Timo-Hauser/POWERPANEL-HW/images/pcb/2d_bottom.png

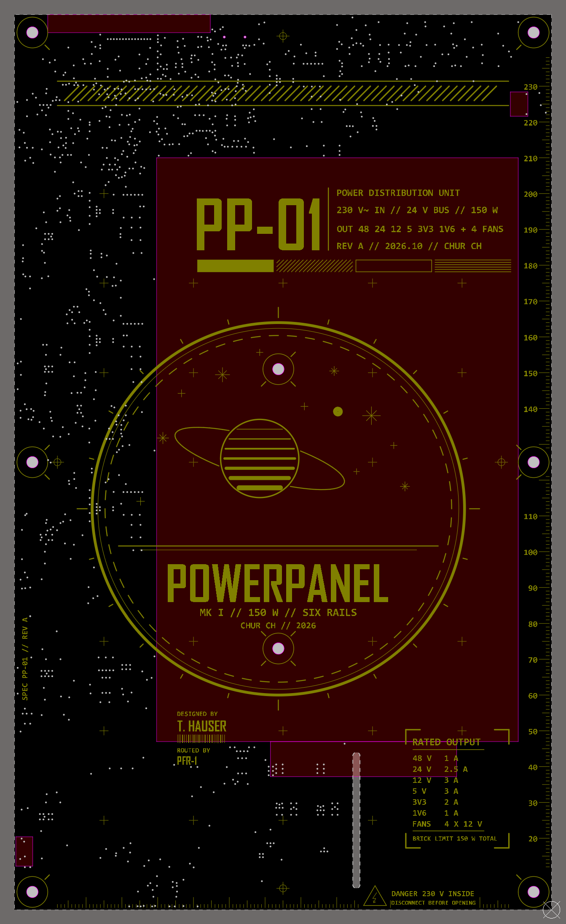
images/pcb/2d_bottom.png
