Timo-Hauser/POWERPANEL-HW/images/pcb/2d_top.png

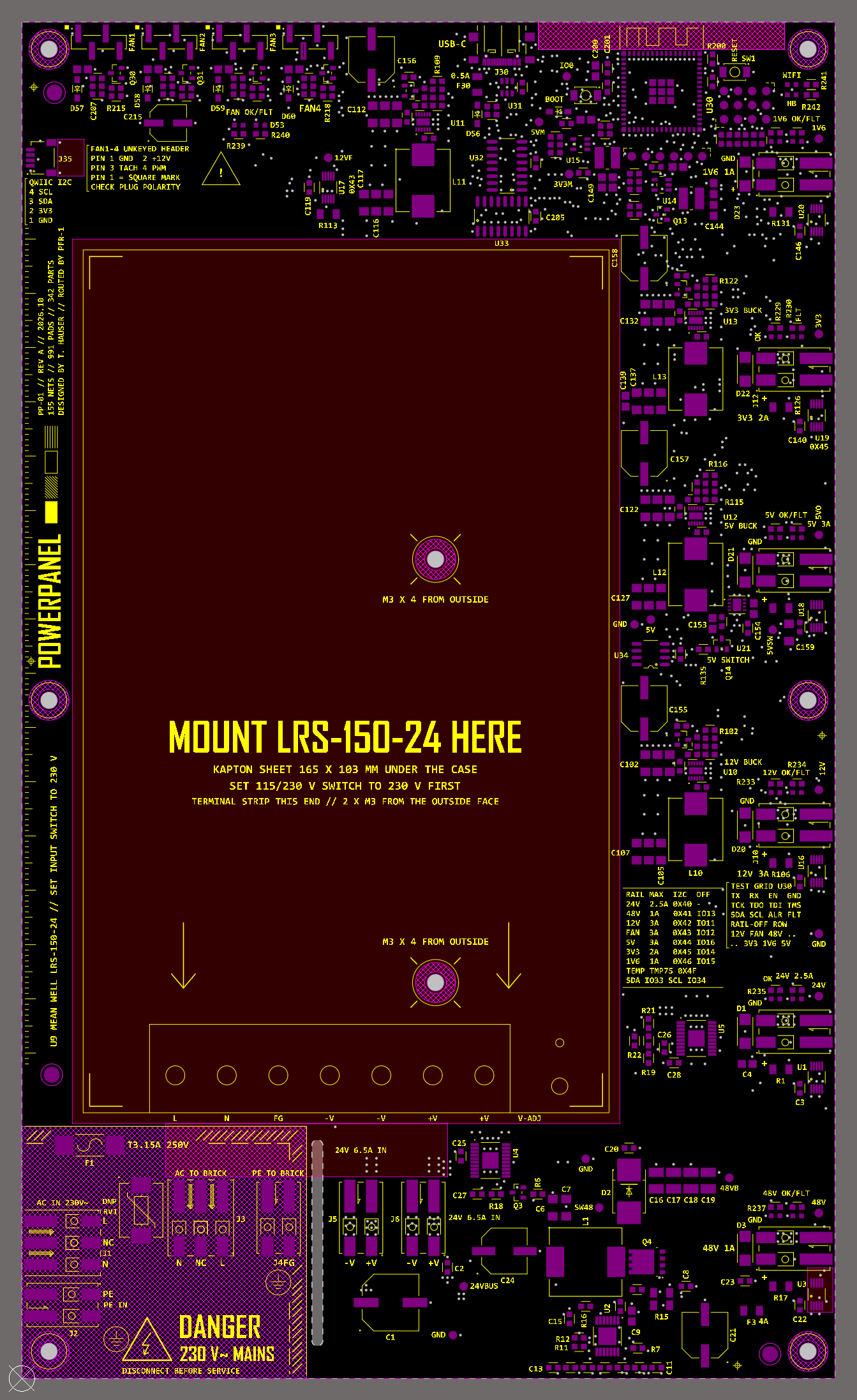
images/pcb/2d_top.png
