Timo-Hauser/POWERPANEL-HW/images/pcb/3d_angled.png

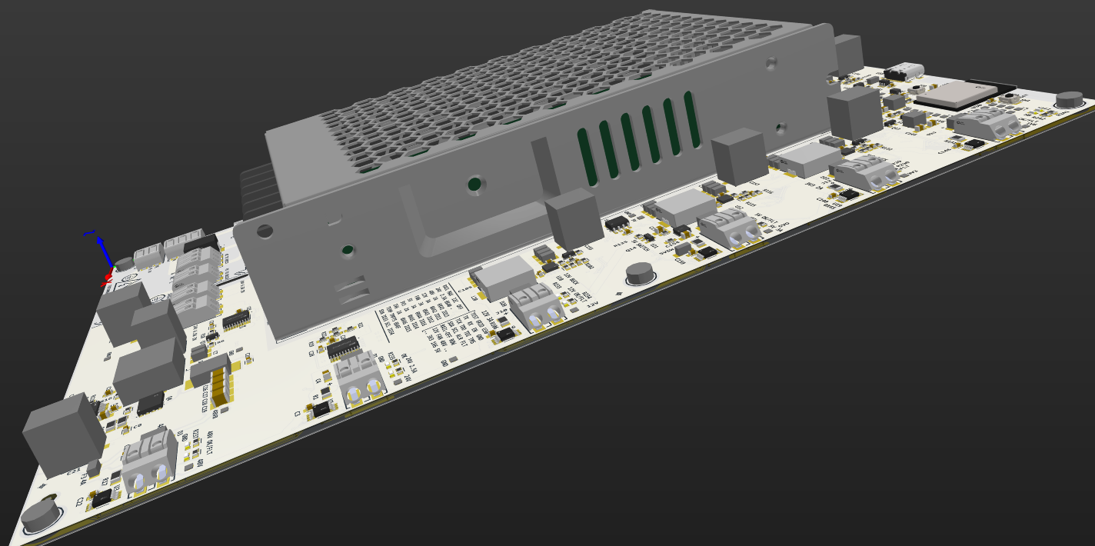
images/pcb/3d_angled.png
