Timo-Hauser/POWERPANEL-HW/images/pcb/3d_emblem.png

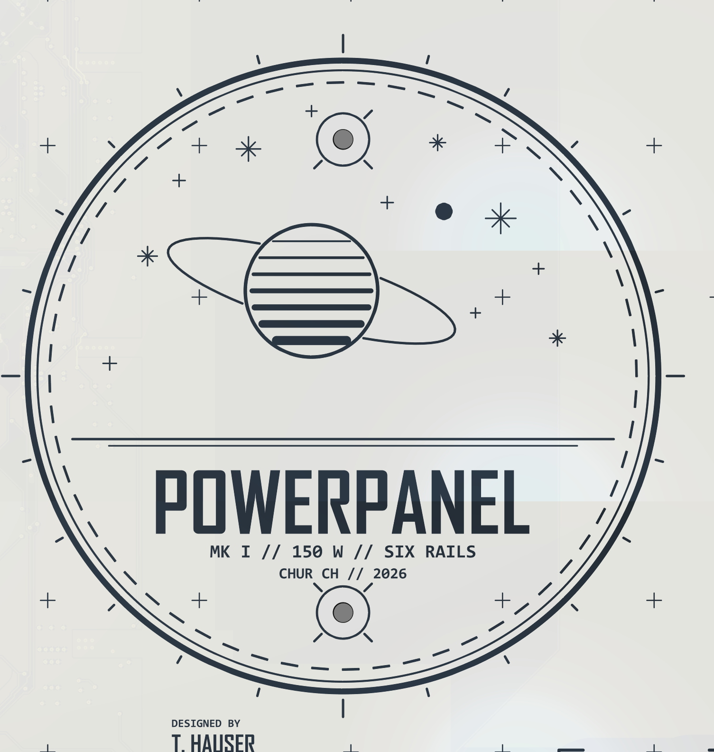
images/pcb/3d_emblem.png
