Timo-Hauser/POWERPANEL-HW/images/pcb/3d_fans.png

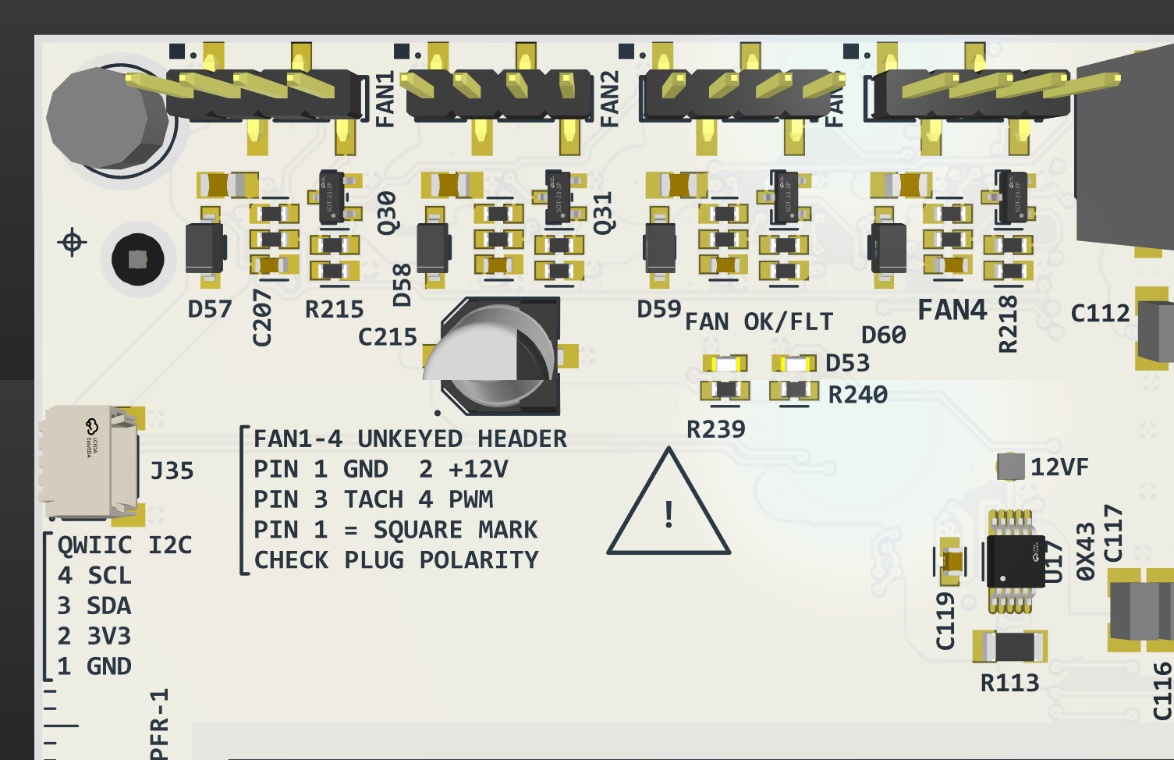
images/pcb/3d_fans.png
