Timo-Hauser/POWERPANEL-HW/images/pcb/3d_mains.png

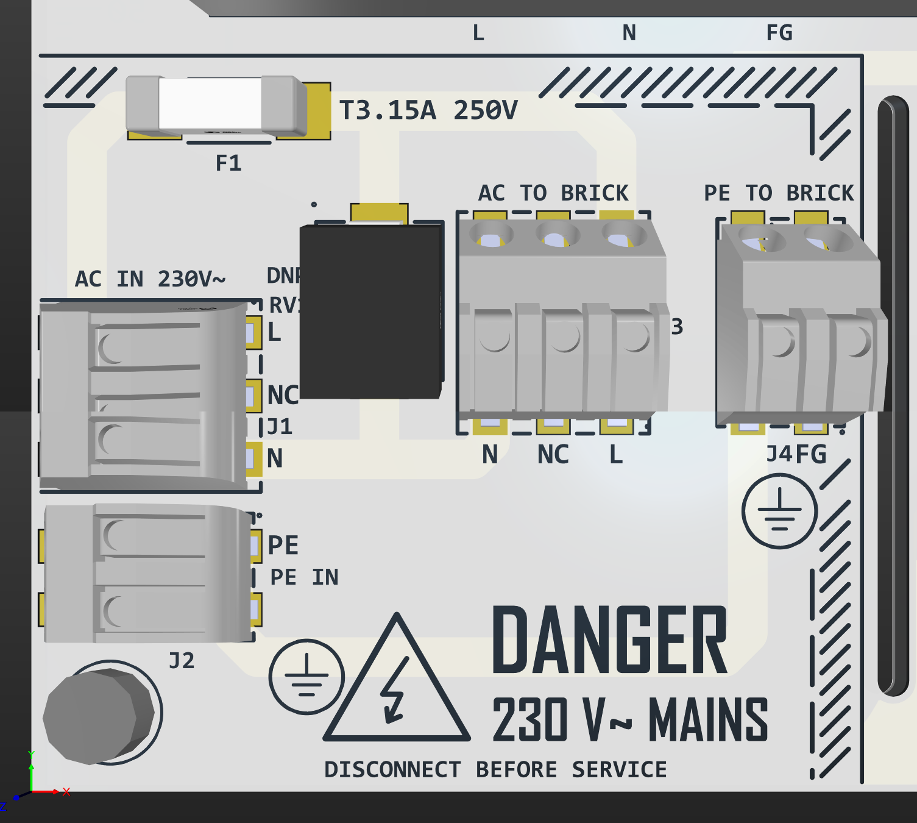
images/pcb/3d_mains.png
