Timo-Hauser/POWERPANEL-HW/images/pcb/3d_psu_top.png

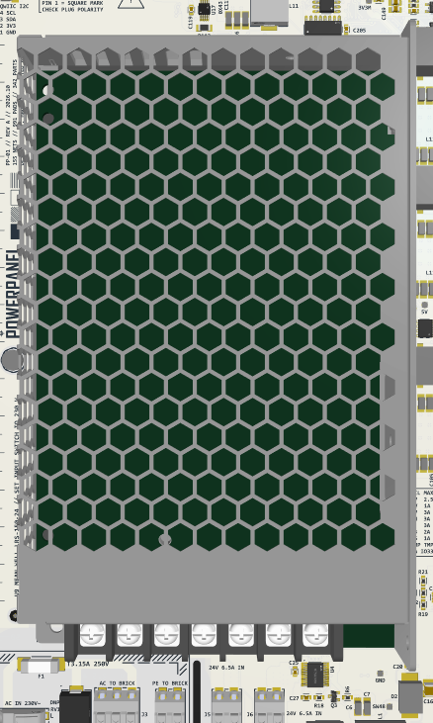
images/pcb/3d_psu_top.png
