Timo-Hauser/POWERPANEL-HW/images/pcb/3d_terminals.png

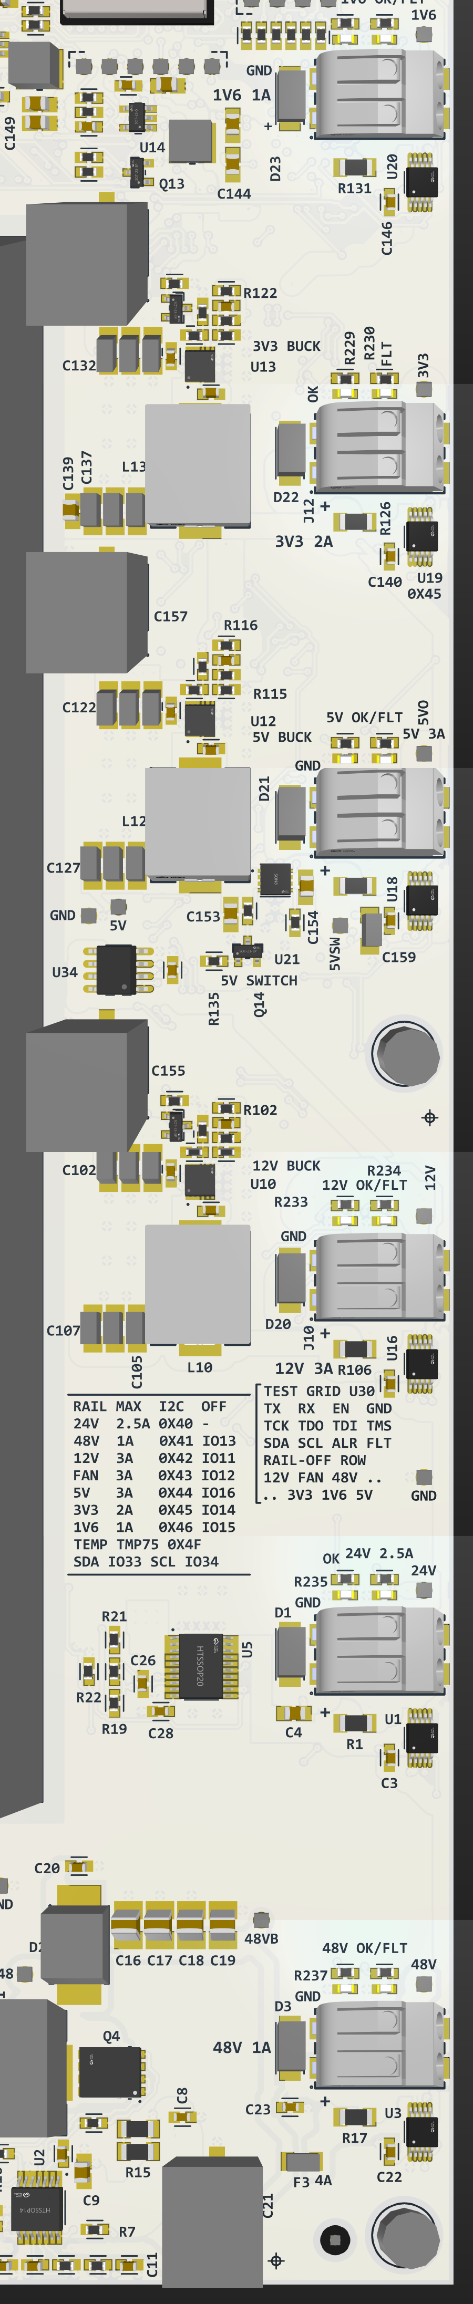
images/pcb/3d_terminals.png
