Timo-Hauser/POWERPANEL-HW/images/pcb/3d_top.png

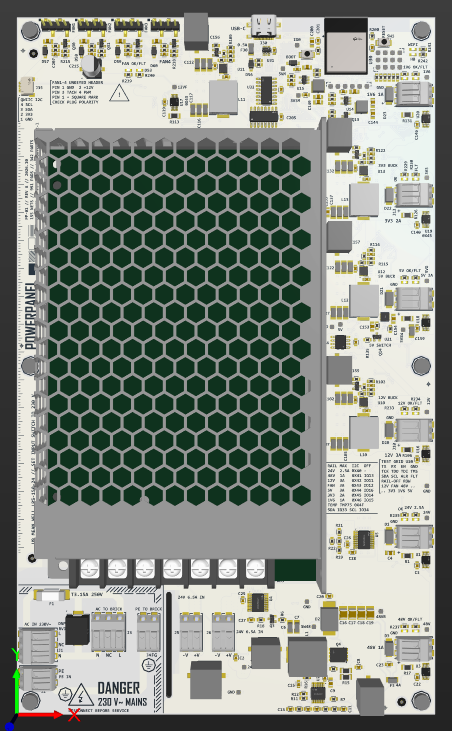
images/pcb/3d_top.png
