Timo-Hauser/POWERPANEL-HW/fab/PowerPanel_BOM_JLC.csv

Comment | Designator | Footprint | LCSC Part #
220U | C1 | CAPAE_D10X10.5 | C46550417
100N | C2,C3,C8,C12,C13,C22,C25,C26,C103,C104,C109,C113,C114,C119,C123,C124,C129,C133,C134,C140,C142,C146,C150,C151,C201,C203,C204,C205,C206 | CAP0603 | C14663
1U | C4,C9 | CAP0805 | C28323
10U | C6,C7,C100,C101,C102,C110,C111,C112,C120,C121,C122,C130,C131,C132 | CAP1206 | C13585
1U | C10,C202 | CAP0603 | C15849
1N | C11,C14 | CAP0603 | C1588
100P | C15 | CAP0603 | C14858
4U7 | C16,C17,C18,C19 | CAP1210 | C381466
100N | C20,C23 | CAP0603 | C15725
47U | C21,C24,C155,C156,C157,C158 | CAPAE_D8X10.5 | C48935391
10N | C27,C28,C207,C208,C209,C210 | CAP0603 | C57112
22U | C105,C106,C107,C115,C116,C117 | CAP1206 | C12891
33P | C108,C118,C128,C138 | CAP0603 | C1663
47U | C125,C126,C127,C135,C136,C137,C159 | CAP1206 | C96123
22U | C139,C143,C144,C148,C149,C200 | CAP0805 | C45783
10U | C141,C147,C153,C154,C211,C212,C213,C214 | CAP0805 | C15850
22P | C145,C152 | CAP0603 | C1653
220U | C215 | CAPAE_D6.3X7.7 | C46550404
24V | D1 | SMA | C19077541
100V 5A | D2 | SMC | C414013
48V | D3 | SMA | C223991
12V | D20 | SMA | C19077532
5V0 | D21,D22,D23 | SMA | C19077523
GREEN | D40,D42,D44,D46,D48,D50,D52 | LED0603 | C965804
RED | D41,D43,D45,D47,D49,D51,D53 | LED0603 | C2286
BLUE | D54 | LED0603 | C965807
WHITE | D55 | LED0603 | C2290
B5819W | D56,D57,D58,D59,D60,D61 | SOD-123 | C8598
3A15 | F1 | FUSE_SCT1032 | C19712564
4A | F3 | FUSE1206 | C136349
500MA | F30 | FUSE1206 | C883126
3P | J1,J3 | TERM_WAGO_2060-453 | C2765056
2P | J2,J4,J5,J6,J7,J8,J10,J11,J12,J13 | TERM_WAGO_2060-452 | C2765055
16P | J30 | USB-C_TYPE-C-16P-QTWT | C5187472
1X4 | J31,J32,J33,J34 | HDR_1X04_M_2.54_SMD_STAG | C41417361
4P | J35 | JST_SM04B-SRSS-TB | C160404
33U | L1 | IND_MWSA1206S | C408530
6U8 | L10,L11 | IND_FXL1040 | C167231
4U7 | L12 | IND_FXL1040 | C167230
3U3 | L13 | IND_FXL1040 | C167229
2U2 | L14,L15 | L_4030 | C167869
2N7002 | Q3,Q10,Q11,Q12,Q13,Q14,Q30,Q31,Q32,Q33 | SOT-23-3 | C8545
BSC160N10NS3G | Q4 | TDSON-8_5X6_EP | C148261
R020 | R1,R106,R113,R119 | R1206 | C371097
100K | R6,R100,R103,R105,R107,R110,R112,R114,R117,R120,R123,R125,R127,R129,R130,R132,R134,R135,R215,R216,R217,R218 | R0603 | C25803
390K | R7,R19 | R0603 | C23150
33K | R8,R136 | R0603 | C4216
56K | R9 | R0603 | C23206
2K2 | R10 | R0603 | C4190
470K | R11 | R0603 | C23178
10K | R12,R104,R111,R118,R124,R200,R201,R208,R209,R210,R219,R220,R221,R222,R243 | R0603 | C25804
0R | R13 | R0603 | C21189
R050 | R14,R15,R17,R131 | R1206 | C20608719
100R | R16,R211,R212,R213,R214 | R0603 | C22775
5K1 | R18,R22,R202,R203 | R0603 | C23186
4K7 | R20,R206,R207 | R0603 | C23162
19K1 | R21,R115 | R0603 | C22897
7K15 | R101,R108 | R0603 | C25980
1K | R102,R109,R116,R122,R223,R224,R225,R226 | R0603 | C21190
31K6 | R121 | R0603 | C25967
R030 | R126 | R1206 | C5375399
60K4 | R128 | R0603 | C23089
22K | R133 | R0603 | C31850
22R | R204,R205 | R0603 | C23345
220R | R227,R229,R231,R233,R235,R237,R239,R241,R242 | R0603 | C22962
470R | R228,R230,R232,R234,R236,R238,R240 | R0603 | C23179
SPST | SW1,SW2 | SW_TS-1088 | C720477
INA226 | U1,U16,U17,U18,U19,U20 | MSOP-10 | C49851
LM5156H | U2 | HTSSOP-14_5X4.4_EP | C2867852
INA237 | U3 | MSOP-10 | C2864837
TPS16630 | U4,U5 | HTSSOP-20_6.5X4.4_EP | C1849461
LMR51450 | U10,U11,U12,U13 | WSON-12_3X3_EP | C6890985
ADJ | U14,U15 | SOT-23-5 | C479074
TPS2557 | U21 | VSON-8_3X3_EP | C130056
ESP32-S2-MINI-2-N4 | U30 | MOD_ESP32-S2-MINI-2 | C3013906
USBLC6-2SC6 | U31 | SOT-23-6 | C2687116
74HC595 | U32,U33 | SOIC-16 | C5947
TMP75 | U34 | SOIC-8 | C30389
