Timo-Hauser/POWERPANEL-HW/(list of files, drawings)

Other design files:
altium/PowerPanel.PrjPcb
altium/PowerPanel_0_Top.SchDoc
altium/PowerPanel_1_Mains_24V_48V.SchDoc
altium/PowerPanel_2_Bucks.SchDoc
altium/PowerPanel_3_LowV_Monitors.SchDoc
altium/PowerPanel_4_MCU_USB.SchDoc
altium/PowerPanel_5_Fans_LEDs_IO.SchDoc
